jacorg/DCI_CESE-7Co2018/(commit log)

2019-05-01 Creación de repo DCI con Datasheet y resumen del proyecto de la CESE
2019-06-03 se agrega carpeta de proyecto con diseño jerarquico y se comenzo por el esquematico de la fuente de alimentación
    [FPGA_Lattice_Replica_Icezum.kicad_pcb, FPGA_Lattice_Replica_Icezum.sch, power_supply.sch]
2019-06-05 se genero esquematico del modulo FPGA y la conexion USB
    [FPGA.sch, FPGA_Lattice_Replica_Icezum.sch, USB_communication.sch, power_supply.sch]
2019-06-10 se completo esquema de perifericos y sockets. Se puso el mismo simbolo de referencia GND en el esquema de la fuente
    [FPGA.sch, FPGA_Lattice_Replica_Icezum.sch, Peripherical.sch, USB_communication.sch, power_supply.sch, socketsAndHeaders.sch]
2019-06-11 se ejecuto y se corrigio electrical rules check
    [FPGA.sch, Peripherical.sch, USB_communication.sch, power_supply.sch, socketsAndHeaders.sch]
2019-06-11 se comenzo asignacion de footprints
    [FPGA.sch, FPGA_Lattice_Replica_Icezum.sch, Peripherical.sch, USB_communication.sch, power_supply.sch, socketsAndHeaders.sch]
2019-06-11 se finalizo asignación de footprint de acuerdo al modelo original de la icezum alhambra
    [FPGA.sch, FPGA_Lattice_Replica_Icezum.sch, Peripherical.sch, USB_communication.sch, power_supply.sch, socketsAndHeaders.sch]
2019-06-11 se coloco hojas de datos de los componentes
    [FPGA.sch, FPGA_Lattice_Replica_Icezum.sch, Peripherical.sch, USB_communication.sch, power_supply.sch, socketsAndHeaders.sch]
2019-06-12 se realizo las correcciones sugeridas por el revisor
    [FPGA.sch, FPGA_Lattice_Replica_Icezum.sch, Peripherical.sch, USB_communication.sch, power_supply.sch, socketsAndHeaders.sch]
2019-06-17 se agregaron mas comentarios a las hojas estado del esquematico: finalizado
    [FPGA.sch, FPGA_Lattice_Replica_Icezum.sch, Peripherical.sch, USB_communication.sch, power_supply.sch, socketsAndHeaders.sch]
2019-06-19 se corrigieron errores de huellas y referencias que genereban errores cuando se hacia el diseño PCB
    [FPGA.sch, FPGA_Lattice_Replica_Icezum.sch, Peripherical.sch, USB_communication.sch, power_supply.sch, socketsAndHeaders.sch]
2019-06-28 se comenzo PCB terminado ordenamiento y borde de placa
    [FPGA_Lattice_Replica_Icezum.kicad_pcb]
2019-07-01 se mejoro esquematico de acuerdo a la revisión del docente. Se mejoro rotulo (se coloco link del repo, autor y autor de la versión original y la licencia) se mejoro el flujo izquiera derecha de los b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
    [FPGA.sch, FPGA_Lattice_Replica_Icezum.kicad_pcb, FPGA_Lattice_Replica_Icezum.sch, Peripherical.sch, USB_communication.sch, power_supply.sch, socketsAndHeaders.sch]
2019-07-02 Posicionamiento y PCB finalizado al 90% realizado en 4 capas. Relleno ce Cu
    [FPGA_Lattice_Replica_Icezum.kicad_pcb]
2019-07-03 nota para fabricante, serigrafia y logo open source. PCB finalizado para presentar
    [FPGA_Lattice_Replica_Icezum.kicad_pcb]
2019-07-15 correcciones de serigrafia, componentes 3D, se corrigio relleno de cobre, simetria en agujero y cambio en la grilla para corte de placa, se corrigieron cuestion de ruteo y uniformidad en la vias. Se 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
    [FPGA_Lattice_Replica_Icezum.kicad_pcb]
