jacorg/DCI_CESE-7Co2018/(notices)

Notices in the files:
FPGA_Lattice_Replica_Icezum/socketsAndHeaders.sch:
License: Creative commons Attribution ShareAlike
